ivanifchen/tea-bags-drawer-divider/docs/img/clip.png

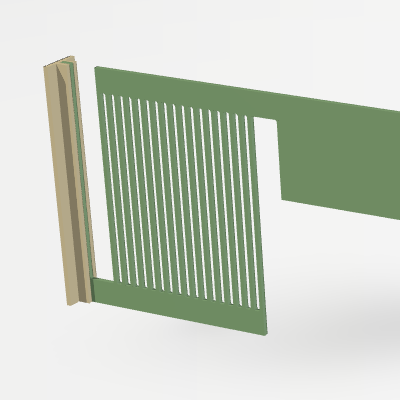
docs/img/clip.png
