ivanifchen/tea-bags-drawer-divider/docs/img/hero.png

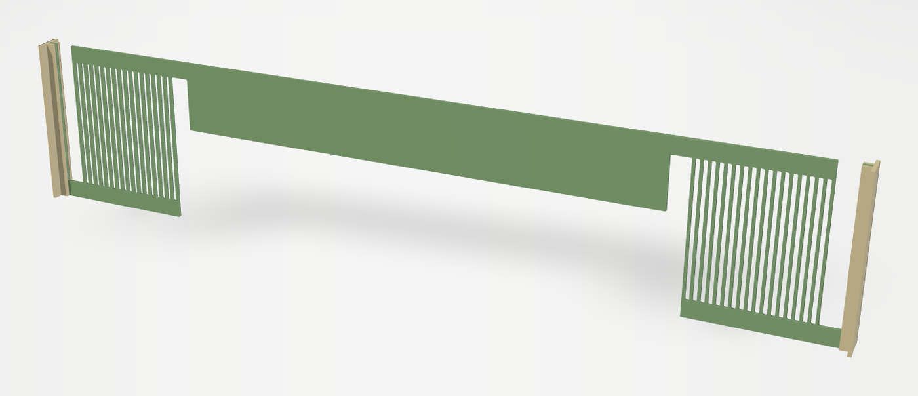
docs/img/hero.png
