ivanifchen/tea-bags-drawer-divider/docs/img/plate.png

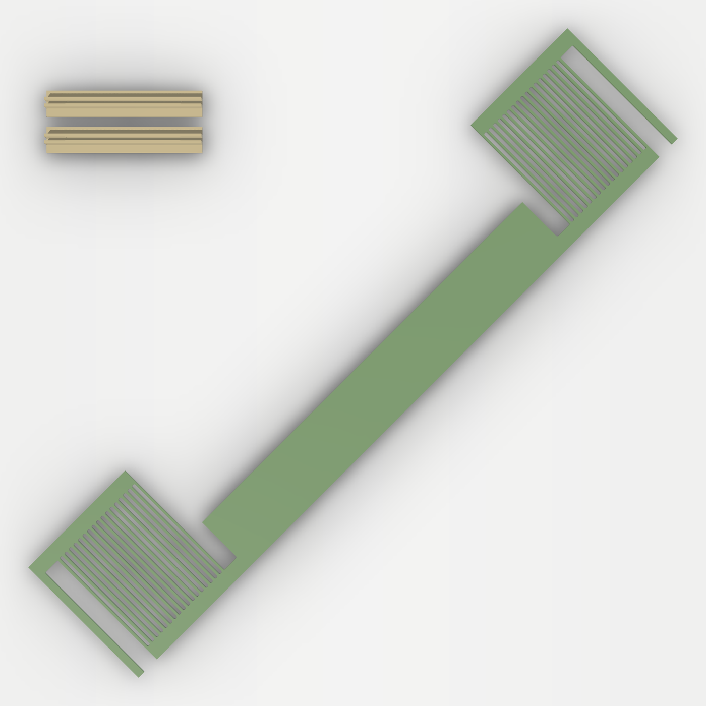
docs/img/plate.png
