ivanifchen/tea-bags-drawer-divider/docs/img/springs.png

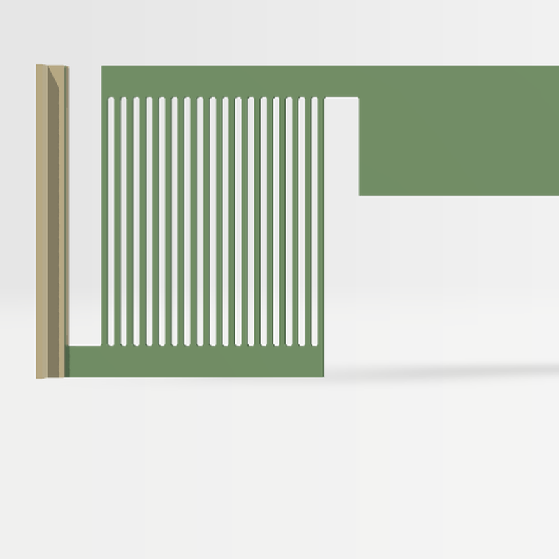
docs/img/springs.png
