ivanifchen/tea-bags-drawer-divider/docs/divider.step

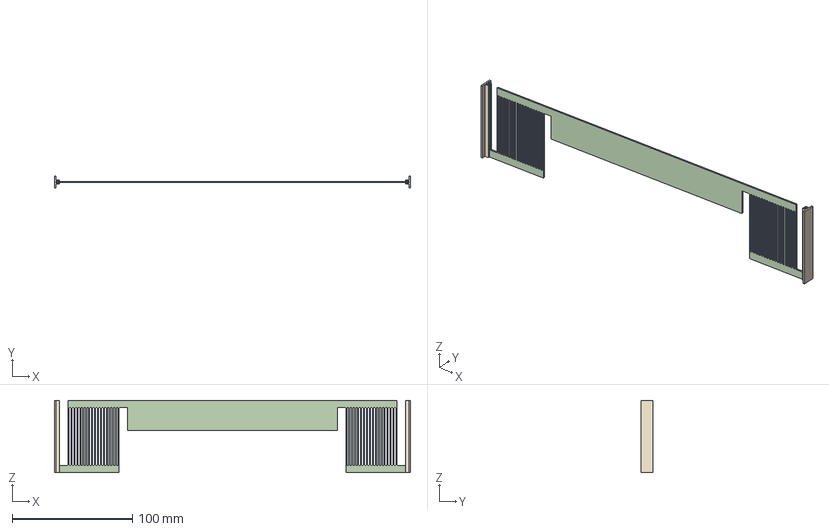
[picture p5: CAD file, 2026-11-08]
docs/divider.step
296.0 x 10.0 x 60.0 mm
wall
t_pad_right x 2
