ivanifchen/tea-bags-drawer-divider/exports/makerworld/t_pad.step

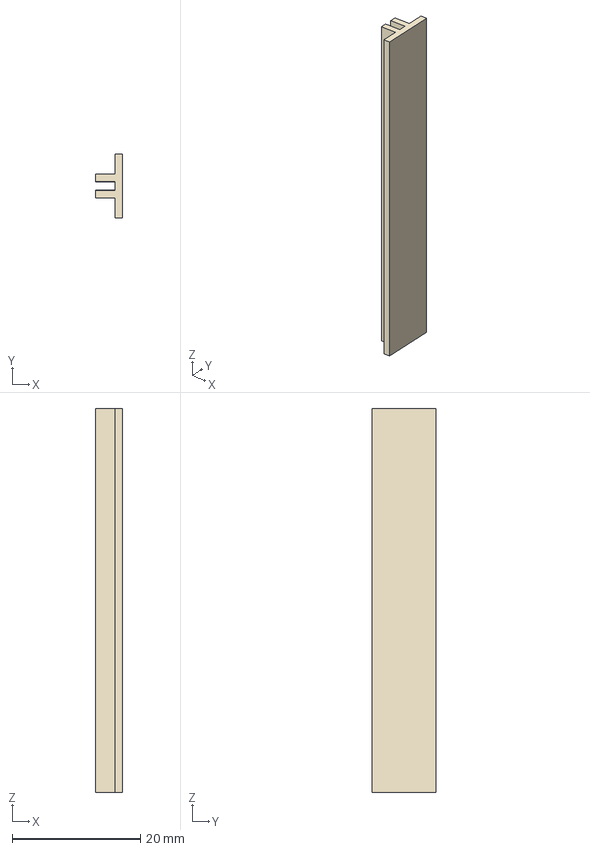
[picture p6: CAD file, 2026-11-08]
exports/makerworld/t_pad.step
4.20 x 10.0 x 60.0 mm
