ivanifchen/tea-bags-drawer-divider/docs/divider_plate.3mf

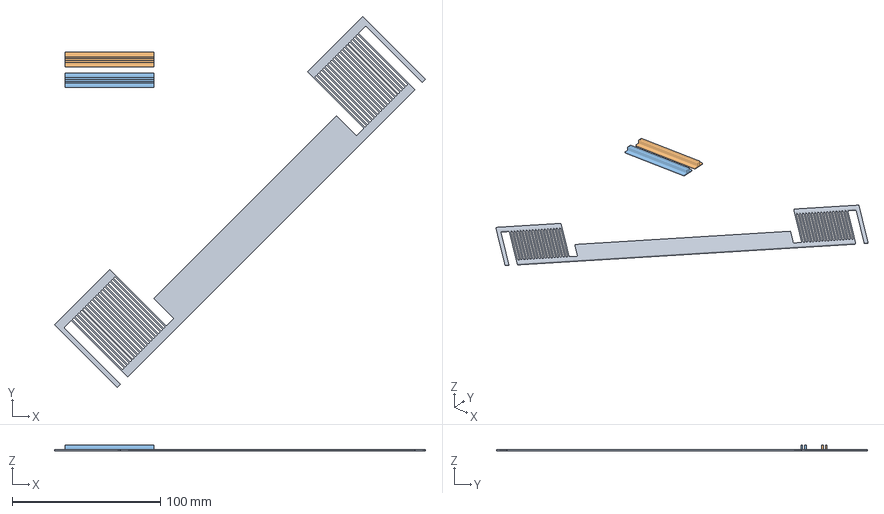
[picture p7: CAD file, 2026-11-08]
docs/divider_plate.3mf
250.0 x 250.0 x 4.20 mm
wall.stl
t_pad_1.stl
t_pad_2.stl
