ivanifchen/tea-bags-drawer-divider/exports/makerworld/wall.step

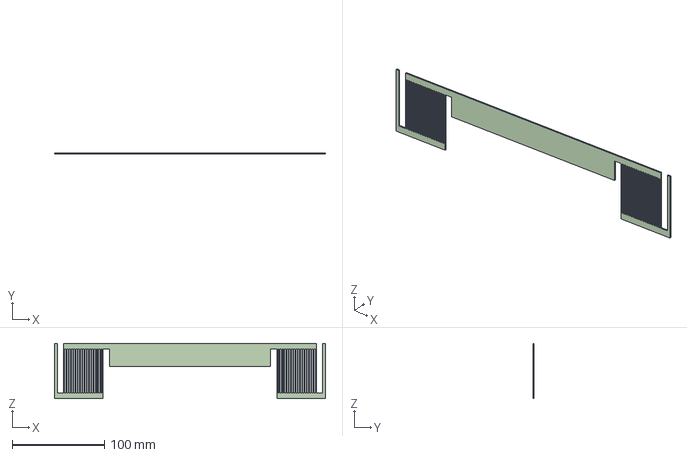
[picture p8: CAD file, 2026-11-08]
exports/makerworld/wall.step
293.6 x 1.20 x 60.0 mm
