ivanifchen/tea-bags-drawer-divider/exports/archive/v1/divider_assembly.step

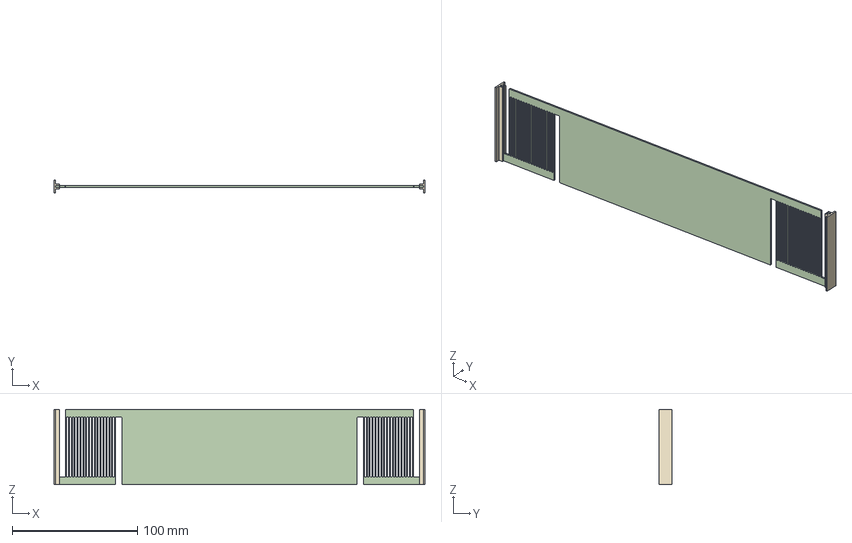
[picture p9: CAD file, 2026-11-08, an earlier design]
exports/archive/v1/divider_assembly.step
296.0 x 10.0 x 60.0 mm
wall
t_pad_right x 2
