ivanifchen/tea-bags-drawer-divider/exports/archive/v2/wall.step

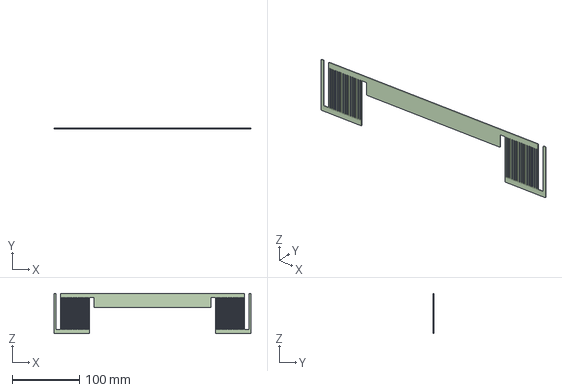
[picture p11: CAD file, 2026-11-08, an earlier design]
exports/archive/v2/wall.step
293.6 x 1.20 x 60.0 mm
