ivanifchen/tea-bags-drawer-divider/exports/archive/v2/divider_plate.3mf

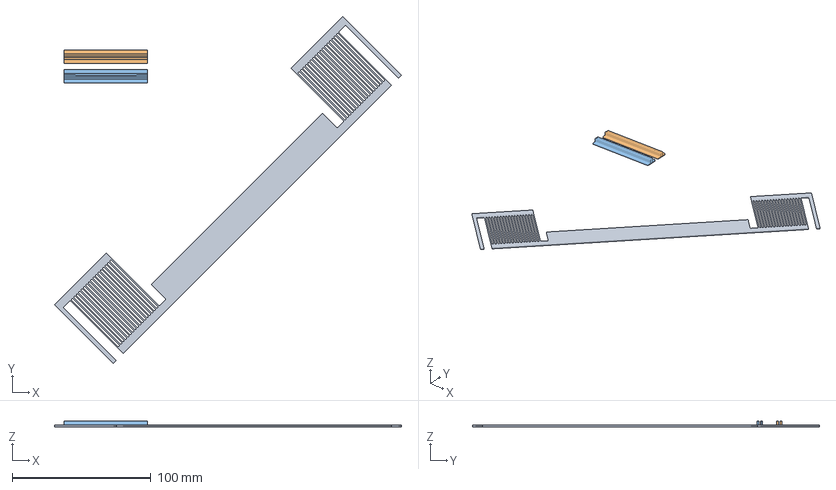
[picture p13: CAD file, 2026-11-08, an earlier design]
exports/archive/v2/divider_plate.3mf
250.0 x 250.0 x 4.20 mm
wall.stl
t_pad_1.stl
t_pad_2.stl
