ivanifchen/tea-bags-drawer-divider/(list of files, cad)

Other CAD files:
exports/archive/v1/t_pad.step
exports/archive/v1/t_pad.3mf
exports/archive/v1/t_pad.stl
exports/archive/v1/wall.3mf
exports/archive/v1/wall.stl
exports/archive/v2/t_pad.3mf
exports/archive/v2/t_pad.stl
exports/archive/v2/wall.3mf
exports/archive/v2/wall.stl
exports/makerworld/t_pad.stl
exports/makerworld/wall.stl
