ivanifchen/tea-bags-drawer-divider/exports/makerworld/01_divider.png

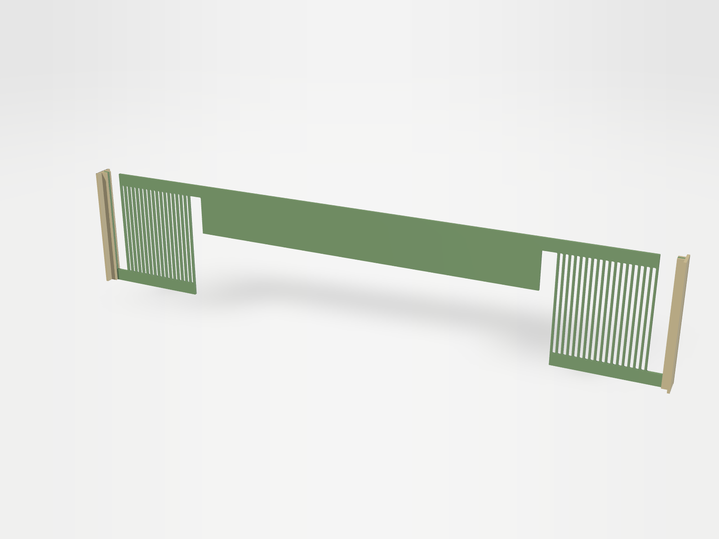
exports/makerworld/01_divider.png
