ivanifchen/tea-bags-drawer-divider/exports/makerworld/03_front.png

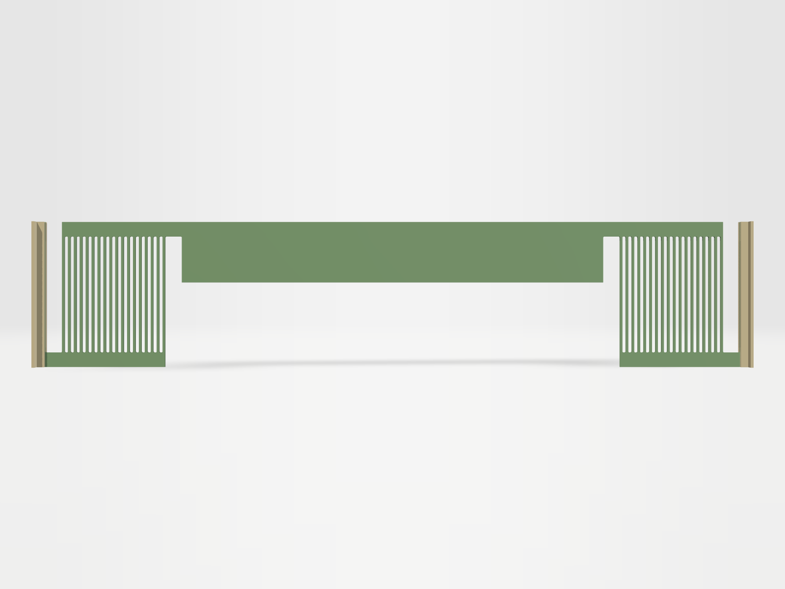
exports/makerworld/03_front.png
