ivanifchen/tea-bags-drawer-divider/(commit log)

2026-11-08 Tea bag drawer divider v3
    Tension-fit divider for a 290 mm drawer: a 1.2 mm PLA wall with an in-plane
    parallel-guided spring at each end and clip-on T-pads. v3 raises the top
    strip to 25 mm for margin against the slight bend seen in the v2 test.
    - src/: build123d models, checks, print plate (Bambu Studio project), exports
    - src/divider.scad: OpenSCAD port for MakerWorld's Customize
    - exports/: v3 plate 3MF and STEP, MakerWorld bundle, tested v1/v2 archive
    - GLOSSARY.md and docs/adr/: terms and design decisions
    [divider.scad, divider.step, divider_assembly.step, divider_plate.3mf, t_pad.3mf, t_pad.step, t_pad.stl, wall.3mf]
2026-11-09 Publish the GitHub Pages site
    docs/index.html with renders in docs/img, plus the print plate 3MF, STEP and
    OpenSCAD script for download. README points to the page and the files.
    [divider.scad, divider.step, divider_plate.3mf]
